koorayworks/Nape-ballcase/ballcase19/Nape-BallCase-19mm-unitpockets-CAD.step

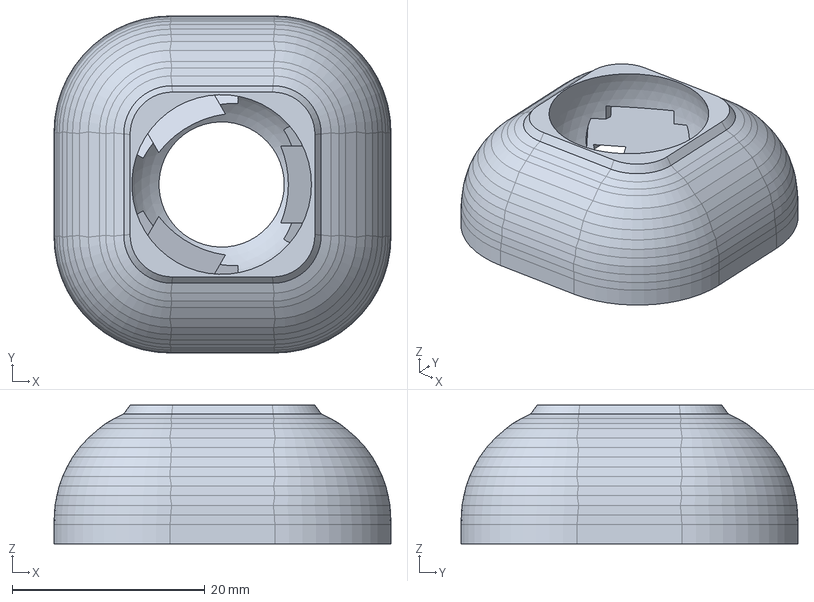
[picture p1: CAD file, 2026-11-05]
ballcase19/Nape-BallCase-19mm-unitpockets-CAD.step
35.0 x 35.0 x 14.4 mm
