koorayworks/Nape-ballcase/ballcase25/Nape-BallCase-25mm-unitpockets-CAD.step

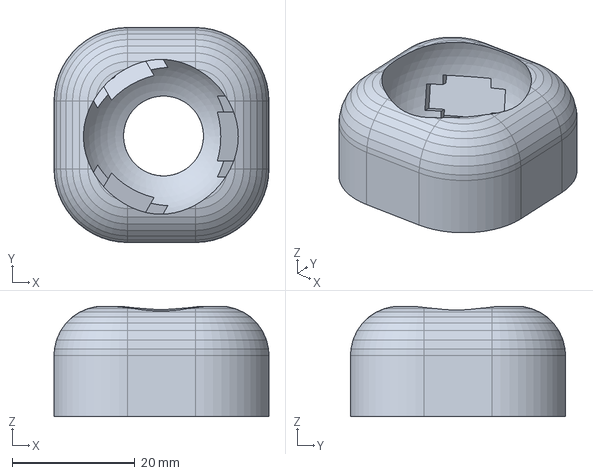
[picture p2: CAD file, 2026-11-03]
ballcase25/Nape-BallCase-25mm-unitpockets-CAD.step
35.0 x 35.0 x 18.0 mm
