koorayworks/Nape-ballcase/ballcase34/Nape-BallCase-34mm-bottom-shim-04.step

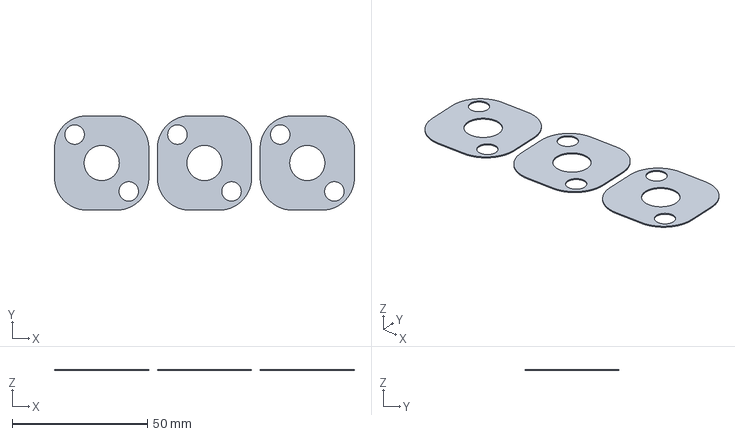
[picture p3: CAD file, 2026-11-03]
ballcase34/Nape-BallCase-34mm-bottom-shim-04.step
110.9 x 34.9 x 0.4 mm
