koorayworks/Nape-ballcase/ballcase34/Nape-BallCase-34mm-bottom-shims.step

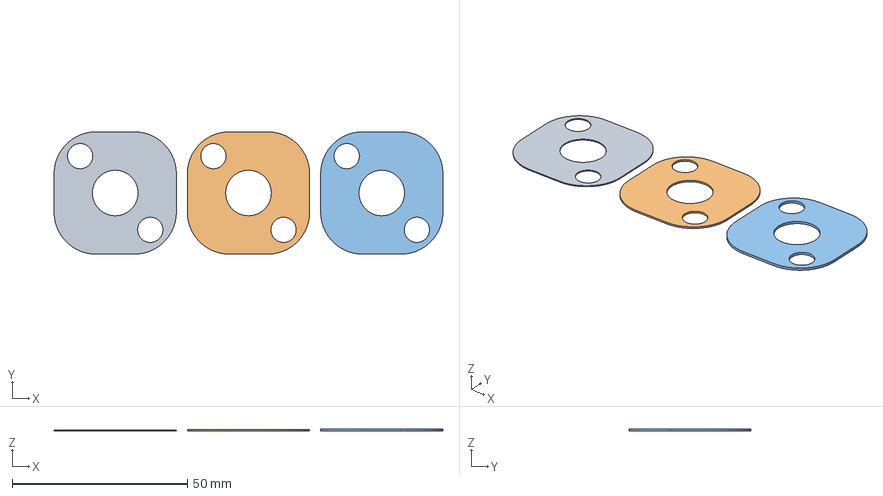
[picture p4: CAD file, 2026-11-03]
ballcase34/Nape-BallCase-34mm-bottom-shims.step
110.9 x 34.9 x 0.7 mm
