koorayworks/Nape-ballcase/ballcase34/Nape-BallCase-34mm-stepped-BS10.step

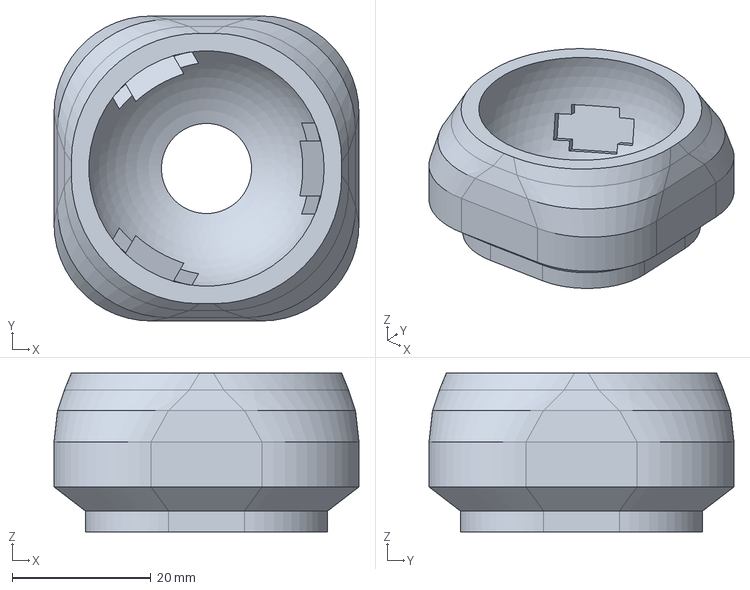
[picture p5: CAD file, 2026-11-03]
ballcase34/Nape-BallCase-34mm-stepped-BS10.step
44.0 x 44.0 x 22.9 mm
