koorayworks/Nape-ballcase/(list of files, cad)

Other CAD files:
ballcase19/Nape-BallCase-19mm-unitpockets-CAD.stl
ballcase25/Nape-BallCase-25mm-unitpockets-CAD.stl
ballcase34/Nape-BallCase-34mm-bottom-shim-04.stl
ballcase34/Nape-BallCase-34mm-bottom-shims.stl
ballcase34/Nape-BallCase-34mm-stepped-BS10.stl
