koorayworks/Nape-ballcase/(commit log)

2026-11-03 Initial: Nape ball case variants with ELECOM support-unit pockets (README + build scripts)
2026-11-03 Add generated STL/STEP: 34mm stepped support-unit ball case (STL in ASCII form)
    [Nape-BallCase-34mm-stepped-BS10.step, Nape-BallCase-34mm-stepped-BS10.stl]
2026-11-03 Add generated STL/STEP: 25mm CAD ball case and 34mm loose-ball STEP (STL in ASCII form)
    [Nape-BallCase-25mm-unitpockets-CAD.step, Nape-BallCase-25mm-unitpockets-CAD.stl, Nape-BallCase-34mm-stepped.step]
2026-11-03 Remove the dia-6 loose-ball variant (not needed)
    [Nape-BallCase-34mm-stepped.step]
2026-11-03 Add case-bottom shims (data + scripts); README: shims as fine adjustment on top of magnets
    [Nape-BallCase-34mm-bottom-shim-04.step, Nape-BallCase-34mm-bottom-shims.step]
2026-11-03 Add case-bottom shim STLs (ASCII form)
    [Nape-BallCase-34mm-bottom-shim-04.stl, Nape-BallCase-34mm-bottom-shims.stl]
2026-11-03 Add CERN-OHL-P-2.0 license text and license notice (derivative of menbou0202/Nape case design)
2026-11-05 Add 19mm CAD ball case with support-unit pockets (pocket height 7.5 extrapolated, not yet print-verified)
    [Nape-BallCase-19mm-unitpockets-CAD.step, Nape-BallCase-19mm-unitpockets-CAD.stl]
